putyn/big_seven/README.md

big_seven
=========

3" seven segments wifi clock with a beautiful wooden case
BigSeven
