putyn/big_seven/case/clock_wood_1.png

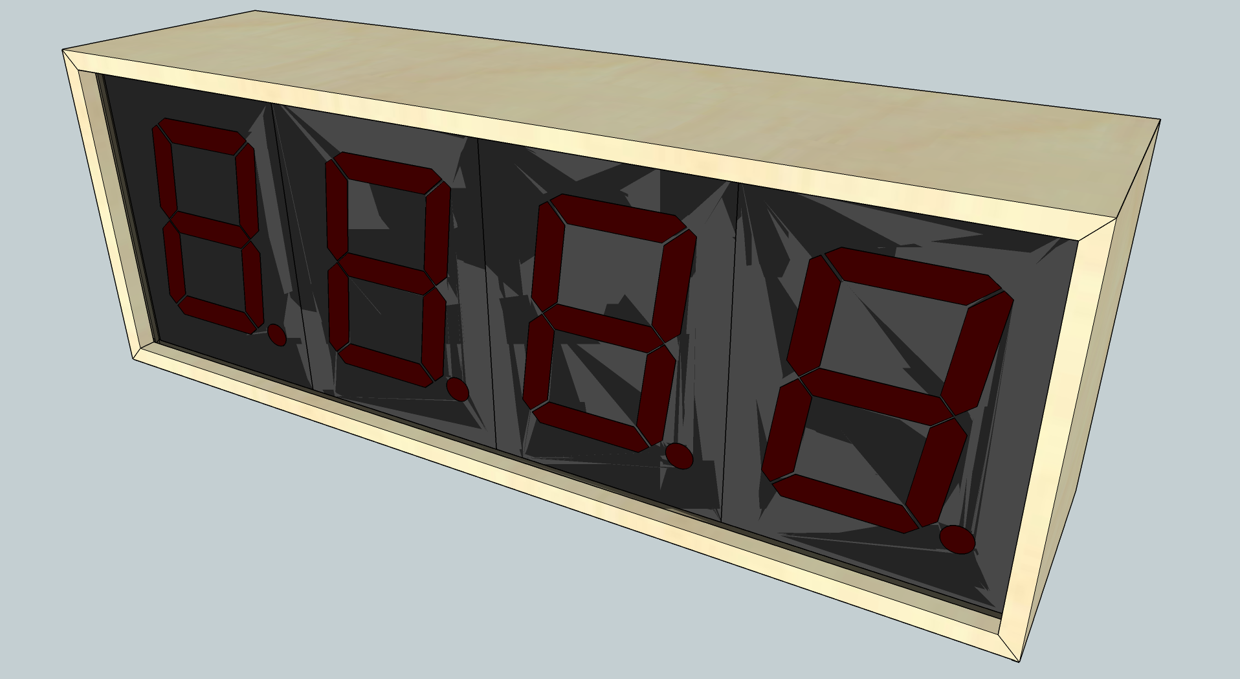
case/clock_wood_1.png
