putyn/big_seven/case/clock_wood_2.png

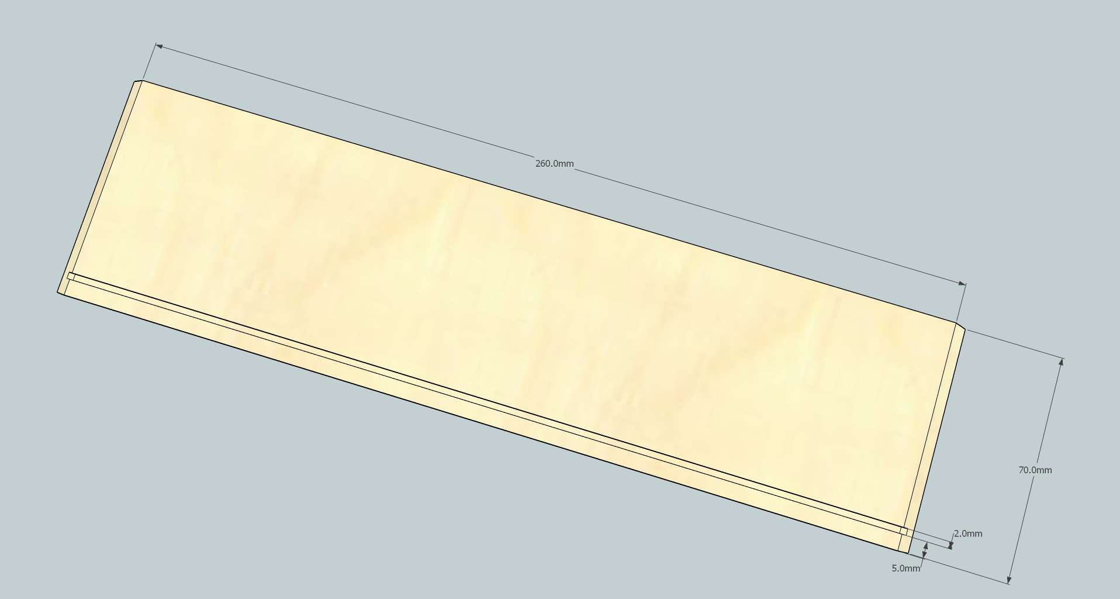
case/clock_wood_2.png
