putyn/big_seven/case/clock_wood_3.png

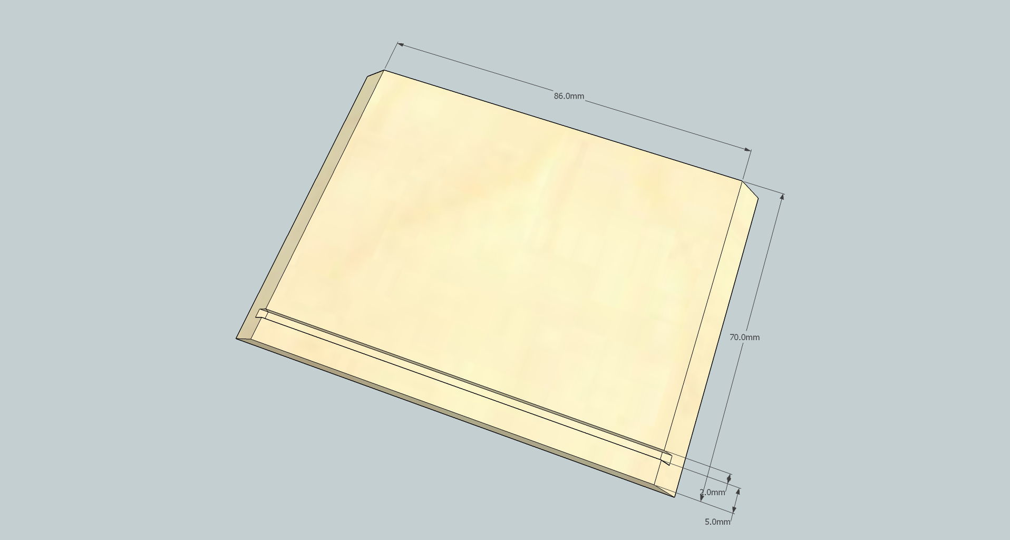
case/clock_wood_3.png
