putyn/big_seven/images/IMG_20160104_074159.jpg

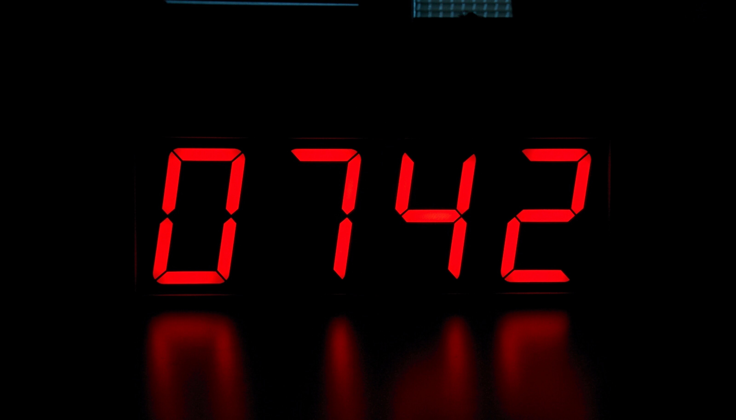
images/IMG_20160104_074159.jpg
