putyn/big_seven/images/IMG_20160104_074300.jpg

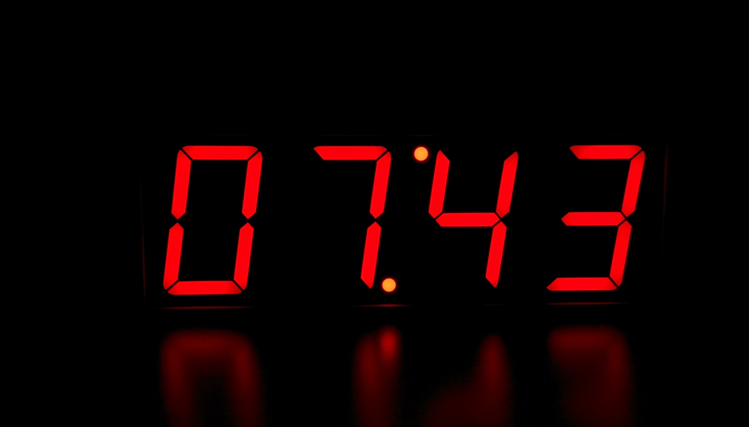
images/IMG_20160104_074300.jpg
