putyn/big_seven/hardware/v0/big_seven_v0.2.brd

## EAGLE design hardware/v0/big_seven_v0.2.brd (2017-03-04)

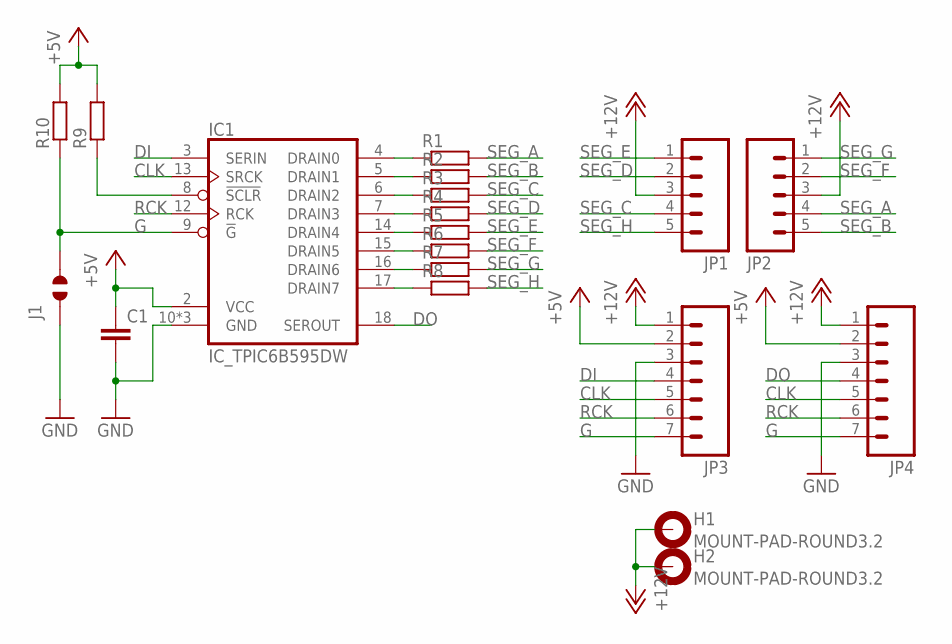
[picture p6: schematic big_seven_v0.2.sch]

Parts:
C1: C-EUC0805; C0805
H1, H2: MOUNT-PAD-ROUND3.2; 3,2-PAD
IC1: IC_TPIC6B595DW; SOIC-20
J1: JUMPER_SOLDER_1X2
JP1, JP2: M05PTH; 1X05
JP3, JP4: M07LONGPADS; 1X07_LONGPADS
R1, R2, R3, R4, R5, R6, R7, R8: R-EU_M1206; M1206
R9, R10: R-EU_M0805; M0805

Connections:
+5V: C1.1, IC1.2 (VCC), JP3.2, JP4.2, R9.2, R10.2
+12V: H1.B3,2, H2.B3,2, JP1.3, JP2.3, JP3.1, JP4.1
CLK: IC1.13 (SRCK), JP3.5, JP4.5
DI: IC1.3 (SERIN), JP3.4
DO: IC1.18 (SEROUT), JP4.4
G: IC1.9 (!G), J1.2, JP3.7, JP4.7, R10.1
GND: C1.2, IC1.10 (GND), IC1.11 (GND), IC1.19 (GND), J1.1, JP3.3, JP4.3
unnamed: IC1.4 (DRAIN0), R1.1
unnamed: IC1.5 (DRAIN1), R2.1
unnamed: IC1.6 (DRAIN2), R3.1
unnamed: IC1.7 (DRAIN3), R4.1
unnamed: IC1.14 (DRAIN4), R5.1
unnamed: IC1.15 (DRAIN5), R6.1
unnamed: IC1.16 (DRAIN6), R7.1
unnamed: IC1.17 (DRAIN7), R8.1
unnamed: IC1.8 (!SCLR), R9.1
RCK: IC1.12 (RCK), JP3.6, JP4.6
SEG_A: JP2.4, R1.2
SEG_B: JP2.5, R2.2
SEG_C: JP1.4, R3.2
SEG_D: JP1.2, R4.2
SEG_E: JP1.1, R5.2
SEG_F: JP2.2, R6.2
SEG_G: JP2.1, R7.2
SEG_H: JP1.5, R8.2

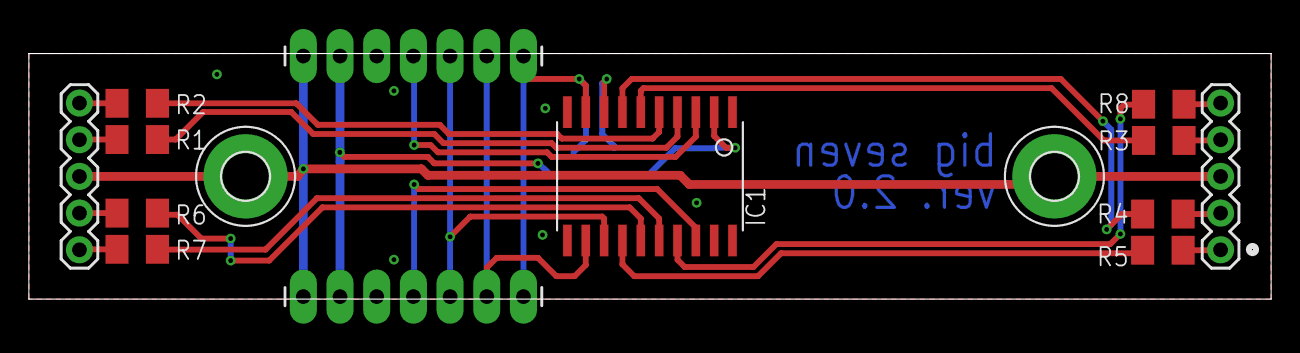
[picture p7: board big_seven_v0.2.brd from above]

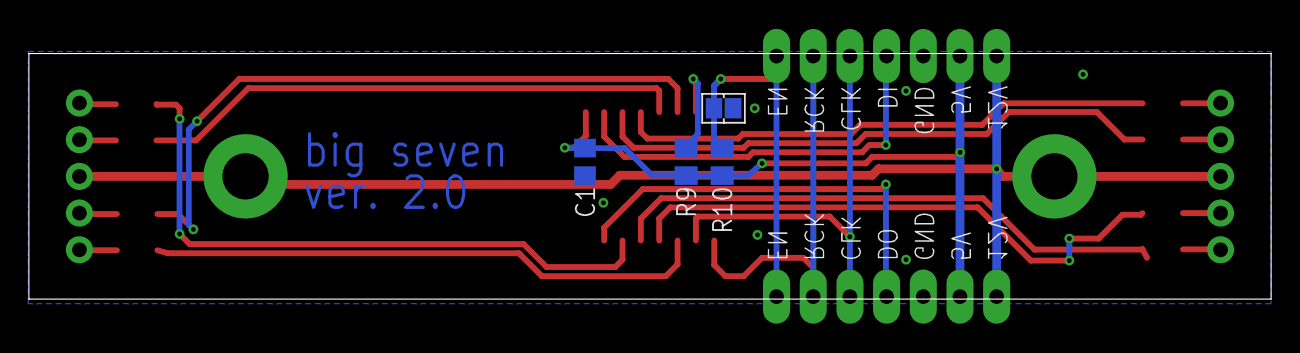
[picture p8: board big_seven_v0.2.brd from below]

Board: 2 copper layers, 86.0 x 17.0 mm, 19 parts (4 on the bottom side), 25 nets.
