putyn/big_seven/hardware/v0/big_seven_control_v0.1.brd

## EAGLE design hardware/v0/big_seven_control_v0.1.brd (2017-03-04, an earlier design)

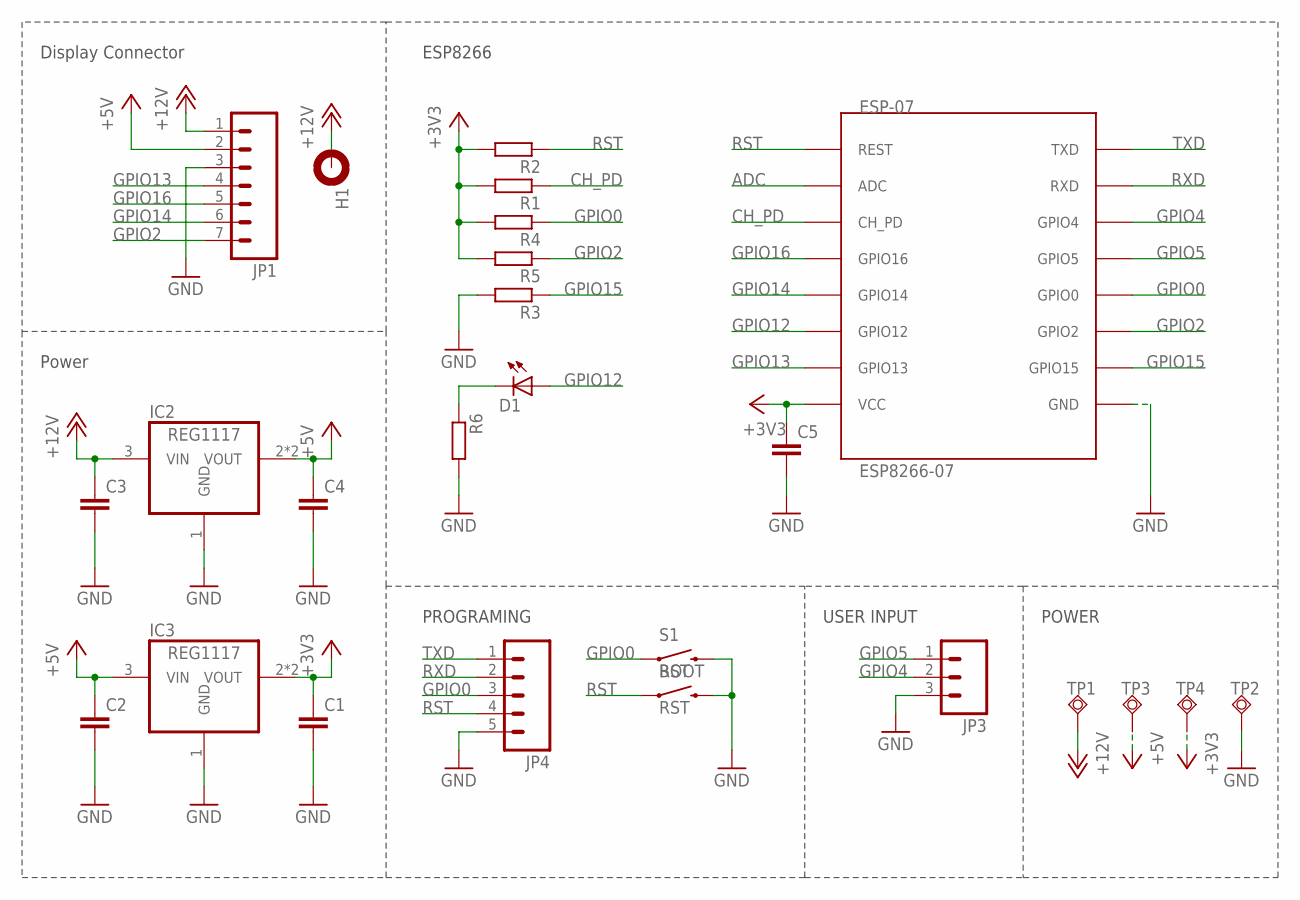
[picture p9: schematic big_seven_control_v0.1.sch]

Parts:
C1, C2, C3, C4: C-EUC1206K; C1206K
C5: C-EUC0805; C0805
D1: LEDCHIP-LED0805; CHIP-LED0805
ESP-07: ESP8266-07; ESP-07
H1: MOUNT-PAD-ROUND3.2; 3,2-PAD
IC2, IC3: REG1117; SOT223
JP1: M07LOCK; 1X07_LOCK
JP3: M03LOCK; 1X03_LOCK
JP4: M05LOCK; 1X05_LOCK
R1, R2, R3, R4, R5, R6: R-EU_R0805; R0805
RST: RST; TACTILE-SWITCH-SMD
S1: BOOT; TACTILE-SWITCH-SMD
TP1: 12V; TP20R
TP2: delk; TP20R
TP3: 5V; TP20R
TP4: 3V3; TP20R

Connections:
+3V3: C1.1, C5.1, ESP-07.VCC, IC3.2 (VOUT), IC3.4 (VOUT), R1.2, R2.2, R4.2, R5.2, TP4.TP
+5V: C2.1, C4.1, IC2.2 (VOUT), IC2.4 (VOUT), IC3.3 (VIN), JP1.2, TP3.TP
+12V: C3.1, H1.B3,2, IC2.3 (VIN), JP1.1, TP1.TP
ADC: ESP-07.ADC
CH_PD: ESP-07.CH_PD, R1.1
GND: C1.2, C2.2, C3.2, C4.2, C5.2, ESP-07.GND, IC2.1 (GND), IC3.1 (GND), JP1.3, JP3.3, JP4.5, R3.2, R6.2, RST.3 (2), S1.3 (2), TP2.TP
GPIO0: ESP-07.GPIO0, JP4.3, R4.1, S1.1
GPIO2: ESP-07.GPIO2, JP1.7, R5.1
GPIO4: ESP-07.GPIO4, JP3.2
GPIO5: ESP-07.GPIO5, JP3.1
GPIO12: D1.A, ESP-07.GPIO12
GPIO13: ESP-07.GPIO13, JP1.4
GPIO14: ESP-07.GPIO14, JP1.5
GPIO15: ESP-07.GPIO15, R3.1
GPIO16: ESP-07.GPIO16, JP1.6
unnamed: D1.C, R6.1
RST: ESP-07.REST, JP4.4, R2.1, RST.1
RXD: ESP-07.RXD, JP4.2
TXD: ESP-07.TXD, JP4.1

Notes on the sheet:
Display Connector
Power
ESP8266
PROGRAMING
USER INPUT
POWER

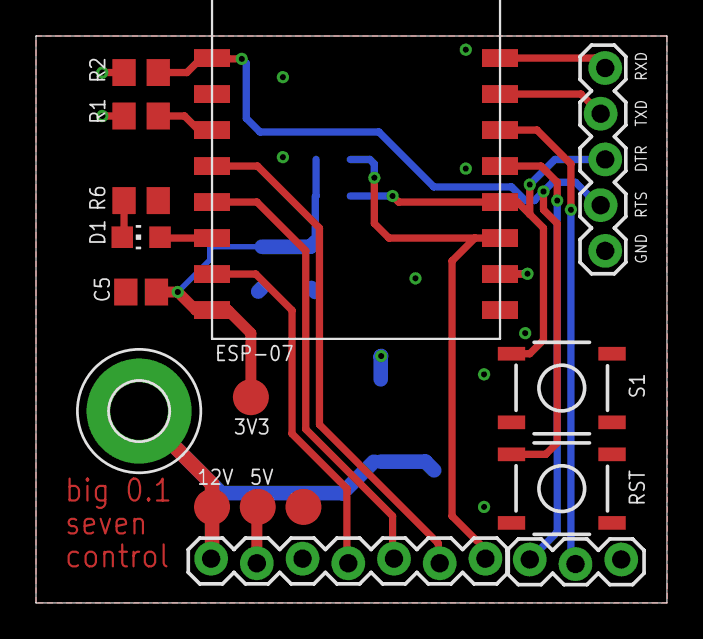
[picture p10: board big_seven_control_v0.1.brd from above]

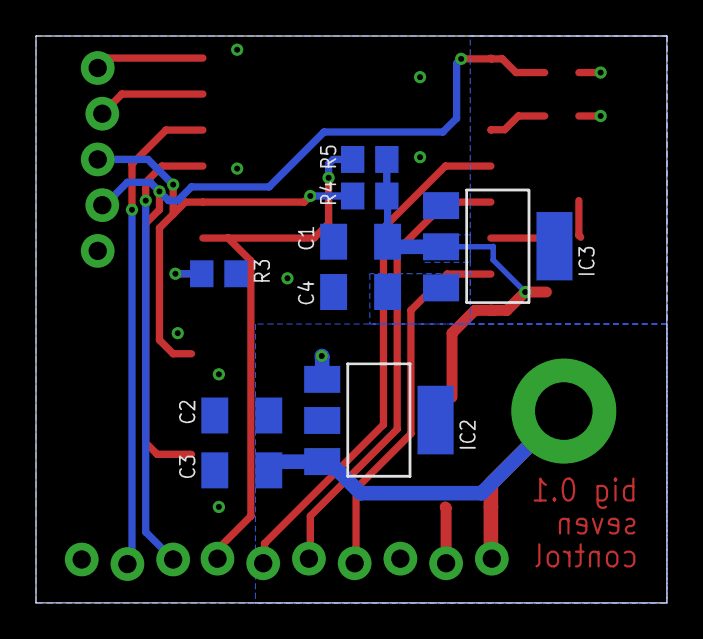
[picture p11: board big_seven_control_v0.1.brd from below]

Board: 2 copper layers, 35.1 x 31.5 mm, 25 parts (9 on the bottom side), 18 nets.
