putyn/big_seven/(commit log)

2017-03-04 initial commit #4
    [big_seven_control_v0.1.brd, big_seven_control_v0.1.sch, big_seven_control_v0.2.brd, big_seven_control_v0.2.sch, big_seven_v0.1.brd, big_seven_v0.1.sch, big_seven_v0.2.brd, big_seven_v0.2.sch]
2017-04-03 clenup + webui work
    HW section added to webui for controlling various things like display brightness, firmware upgrade
    [big_seven_control_v0.1.brd, big_seven_control_v0.1.sch, big_seven_control_v0.2.brd, big_seven_control_v0.2.sch, big_seven_v0.1.brd, big_seven_v0.1.sch, big_seven_v0.2.brd, big_seven_v0.2.sch]
